nicolaeandreivasile/bike-embedded-app/README.md

# bike-embedded-app

## General description

Embedded application for bikes that collect and display various riding data.
