nicolaeandreivasile/bike-embedded-app/embedded/prototype-C/board-design/esp32-main/esp32-3d-images/esp32-main_z_normal.png

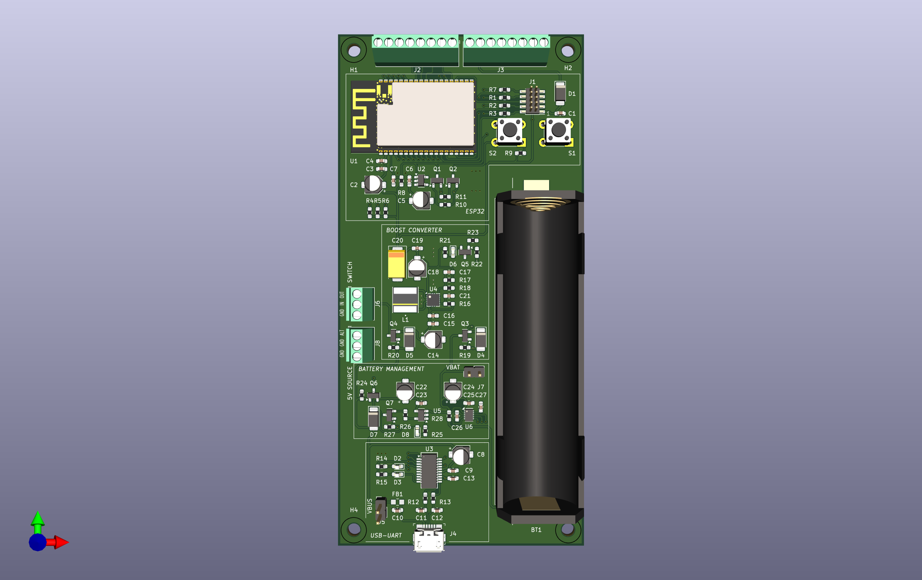
embedded/prototype-C/board-design/esp32-main/esp32-3d-images/esp32-main_z_normal.png
