nicolaeandreivasile/bike-embedded-app/embedded/prototype-C/board-design/esp32-main/esp_main_models/NRS6010T1R5MMGF/IND_TAIYO_NRS6010_TAY.step

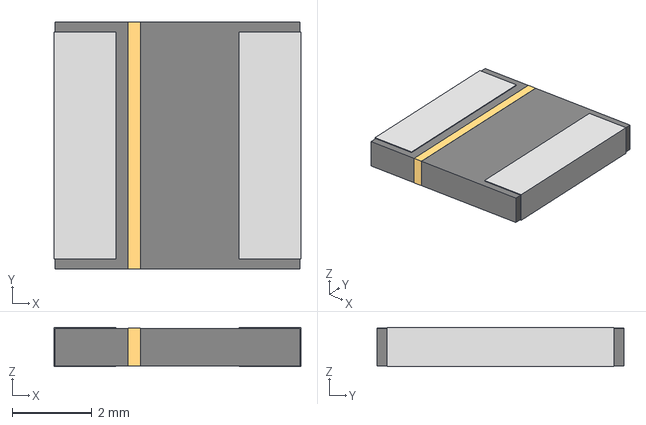
[picture p8: CAD file, 2024-12-30]
embedded/prototype-C/board-design/esp32-main/esp_main_models/NRS6010T1R5MMGF/IND_TAIYO_NRS6010_TAY.step
6.20 x 6.20 x 0.991 mm
