nicolaeandreivasile/bike-embedded-app/(commit log)

2024-10-02 [bike-embedded-app]
    Added schematics for USB to Full Handshake UART IC and Synchronous Boost
    Converter.
    [battery.kicad_sch, esp32-main.kicad_pcb, esp32-main.kicad_sch, power-supply.kicad_sch, usb-uart.kicad_sch]
2024-10-03 [bike-embedded-app]
    Finished first schematic draft.
    [battery.kicad_sch, esp32-main.kicad_sch, power-supply.kicad_sch, usb-uart.kicad_sch]
2024-10-04 [bike-embedded-app]
    First draft of the part placement on PCB. No routes drawn yet. Added
    entry for possible alternator.
    [battery.kicad_sch, esp32-main.kicad_pcb, esp32-main.kicad_sch, power-supply.kicad_sch]
2024-10-04 [bike-embedded-app]
    Finished first draft of the embedded hardware app. PCB design
    constraints follow PCBWay recommendations.
    [battery.kicad_sch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]
2024-10-05 [bike-embedded-app]
    Completed first draft of PCB + gerbers.
    [esp32-main-B_Cu.gbr, esp32-main-B_Mask.gbr, esp32-main-B_Paste.gbr, esp32-main-B_Silkscreen.gbr, esp32-main-Edge_Cuts.gbr, esp32-main-F_Cu.gbr, esp32-main-F_Mask.gbr, esp32-main-F_Paste.gbr]
2024-10-07 [bike-embedded-app]
    Finalized purchase list and 3D models.
    [esp32-main-BOM.csv, esp32-main-digikey-list.csv, esp32-main.kicad_pcb]
2024-10-12 [bike-embedded-app]
    Added output for 3V3. Increased mounting holes.
    [battery.kicad_sch, esp32-main.kicad_pcb, esp32-main.kicad_sch, power-supply.kicad_sch, usb-uart.kicad_sch]
2024-10-12 [bike-embedded-app]
    Refactored directory structure.
    [battery.kicad_sch, esp32-main-BOM.csv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]
2024-10-12 [prototype-B]
    Refactored board size and battery switch design. Updated 3D model,
    gerber and drill files, and BOM.
    [battery.kicad_sch, esp32-main-BOM.csv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]
2024-10-13 [prototype-B]
    Updated prototype-B README.md. Refactored schematic.
    [battery.kicad_sch, esp32-main.kicad_sch, power-supply.kicad_sch, usb-uart.kicad_sch]
2024-10-13 [prototype-B]
    Fixed prototype-B README.md
2024-10-13 [prototype-B]
    Refactored power scheme.
    [battery.kicad_sch, power-supply.kicad_sch, usb-uart.kicad_sch]
2024-10-14 [prototype-B]
    Refactored power scheme. Updated prototype-B README.md.
    [battery.kicad_sch, power-supply.kicad_sch]
2024-10-17 [prototype-B]
    Refactored hardware implementation.
    [battery.kicad_sch, esp32-main.kicad_pcb, esp32-main.kicad_sch, power-supply.kicad_sch, usb-uart.kicad_sch]
2024-10-17 [prototype-B]
    Work in progress - refactoring hardware implementation.
    [esp32-main.kicad_pcb, esp32-main.kicad_sch]
2024-10-26 [prototype-B]
    Refactored hardware implementation. Reduced board size.
    [IND_TAIYO_NRS6010_TAY.step, battery.kicad_sch, esp32-main-BOM.csv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]
2024-11-10 [prototype-B]
    Updated README.md with observed issues and additional implementation
    information.
2024-11-16 [Updated README.md]
    Updated prototype-B README.md with additional information and tasks.
2024-11-16 [Update README.md and tests]
    Update README.md files with current information and added validation
    tests for the prototype-B.
2024-11-19 [Update prototype-B repo]
    Refactored directory tree. Added datasheets. Updated board-design
    README.md.
    [IND_TAIYO_NRS6010_TAY.step, battery.kicad_sch, esp32-main-BOM.csv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]
2024-11-19 [Update directory tree]
    Erase old directory tree.
    [IND_TAIYO_NRS6010_TAY.step, battery.kicad_sch, esp32-main-BOM.csv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]
2025-03-17 [Main branch]
    Centralized all the work that has been done so far.
    [battery.kicad_sch, esp32-main-BOM.csv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]
2025-03-23 [prototype-C]
    First draft of the main ESP32 added.
    [IND_TAIYO_NRS6010_TAY.step, battery.kicad_sch, esp32-main-BOM.csv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]
